ChoppedxVeggies/BatteryTester/README.md

# BatteryTester
Repo for the micocontroller based Battery Tester project
