ChoppedxVeggies/BatteryTester/Datasheets/Battery tester schematic.pdf

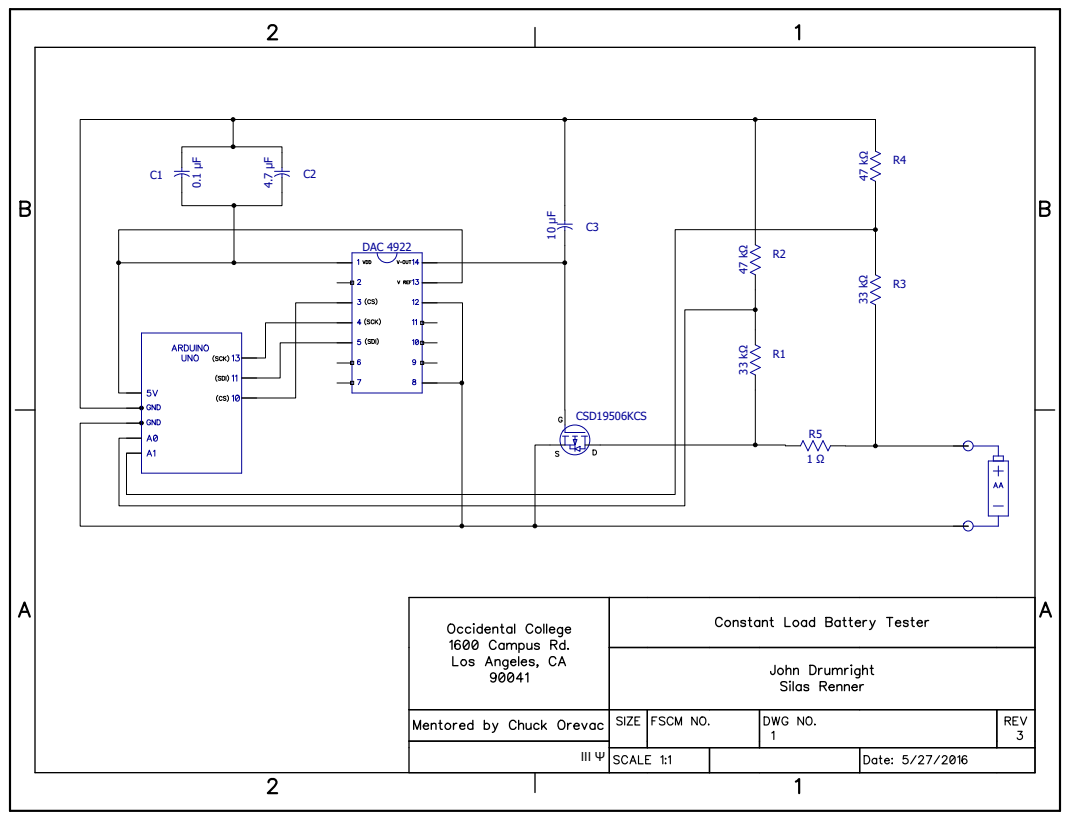
[picture p1: page 1]
